Alej9494/rpn-calculator/hardware/kicad/rpn-calculator.kicad_sch

## KiCad design hardware/kicad/rpn-calculator.kicad_sch (2026-11-07)

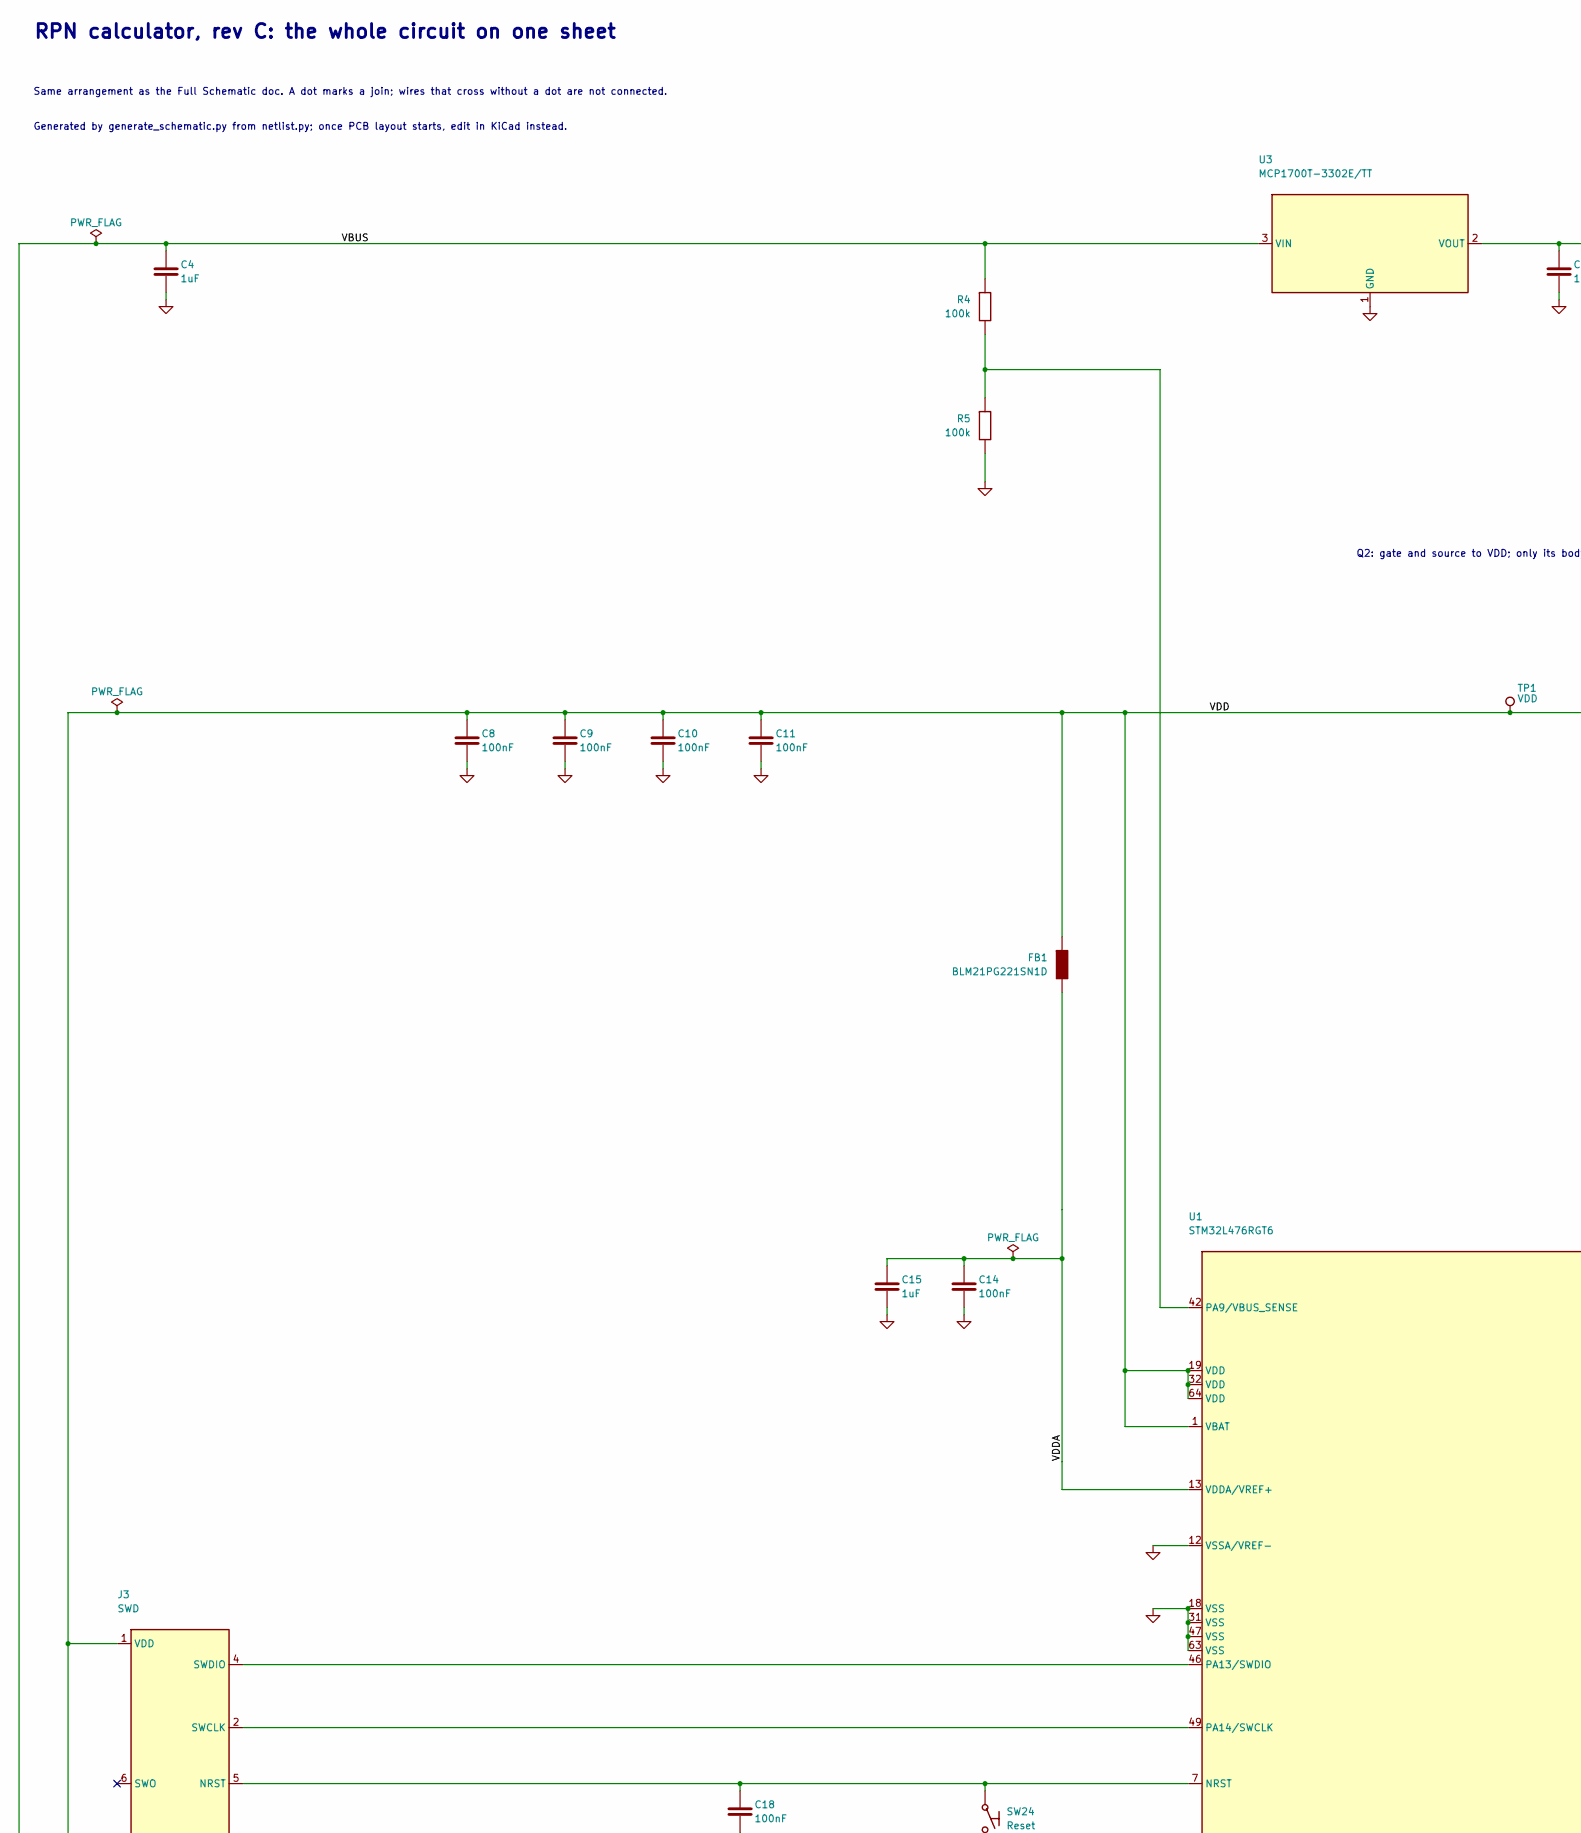
[picture p3: schematic rpn-calculator.kicad_sch, part in row 1, column 1]

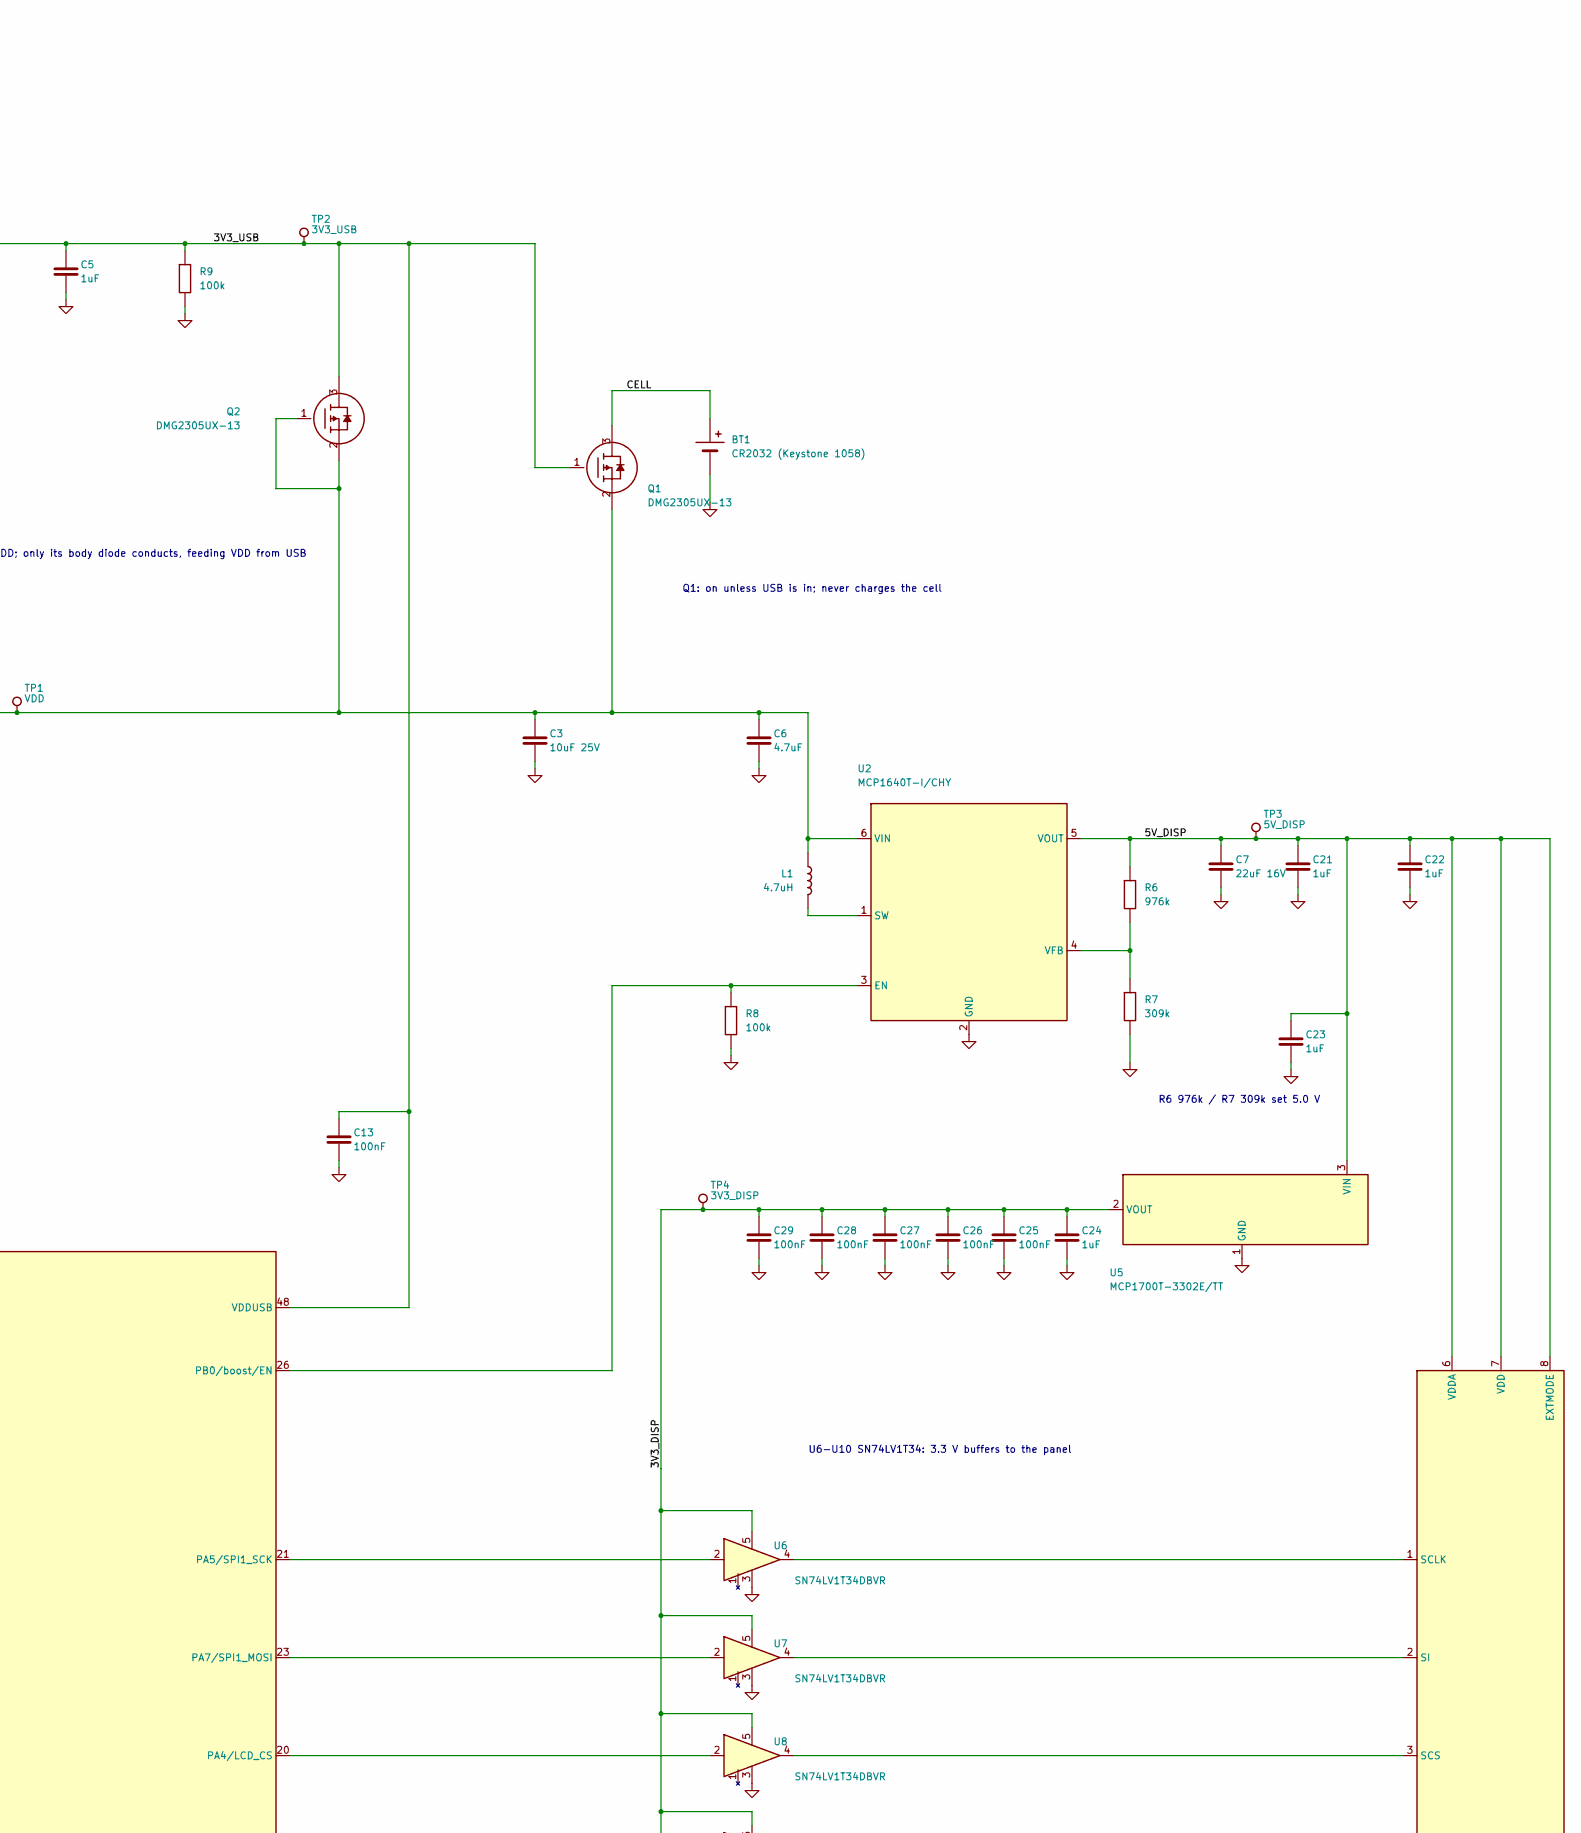
[picture p4: schematic rpn-calculator.kicad_sch, part in row 1, column 2]

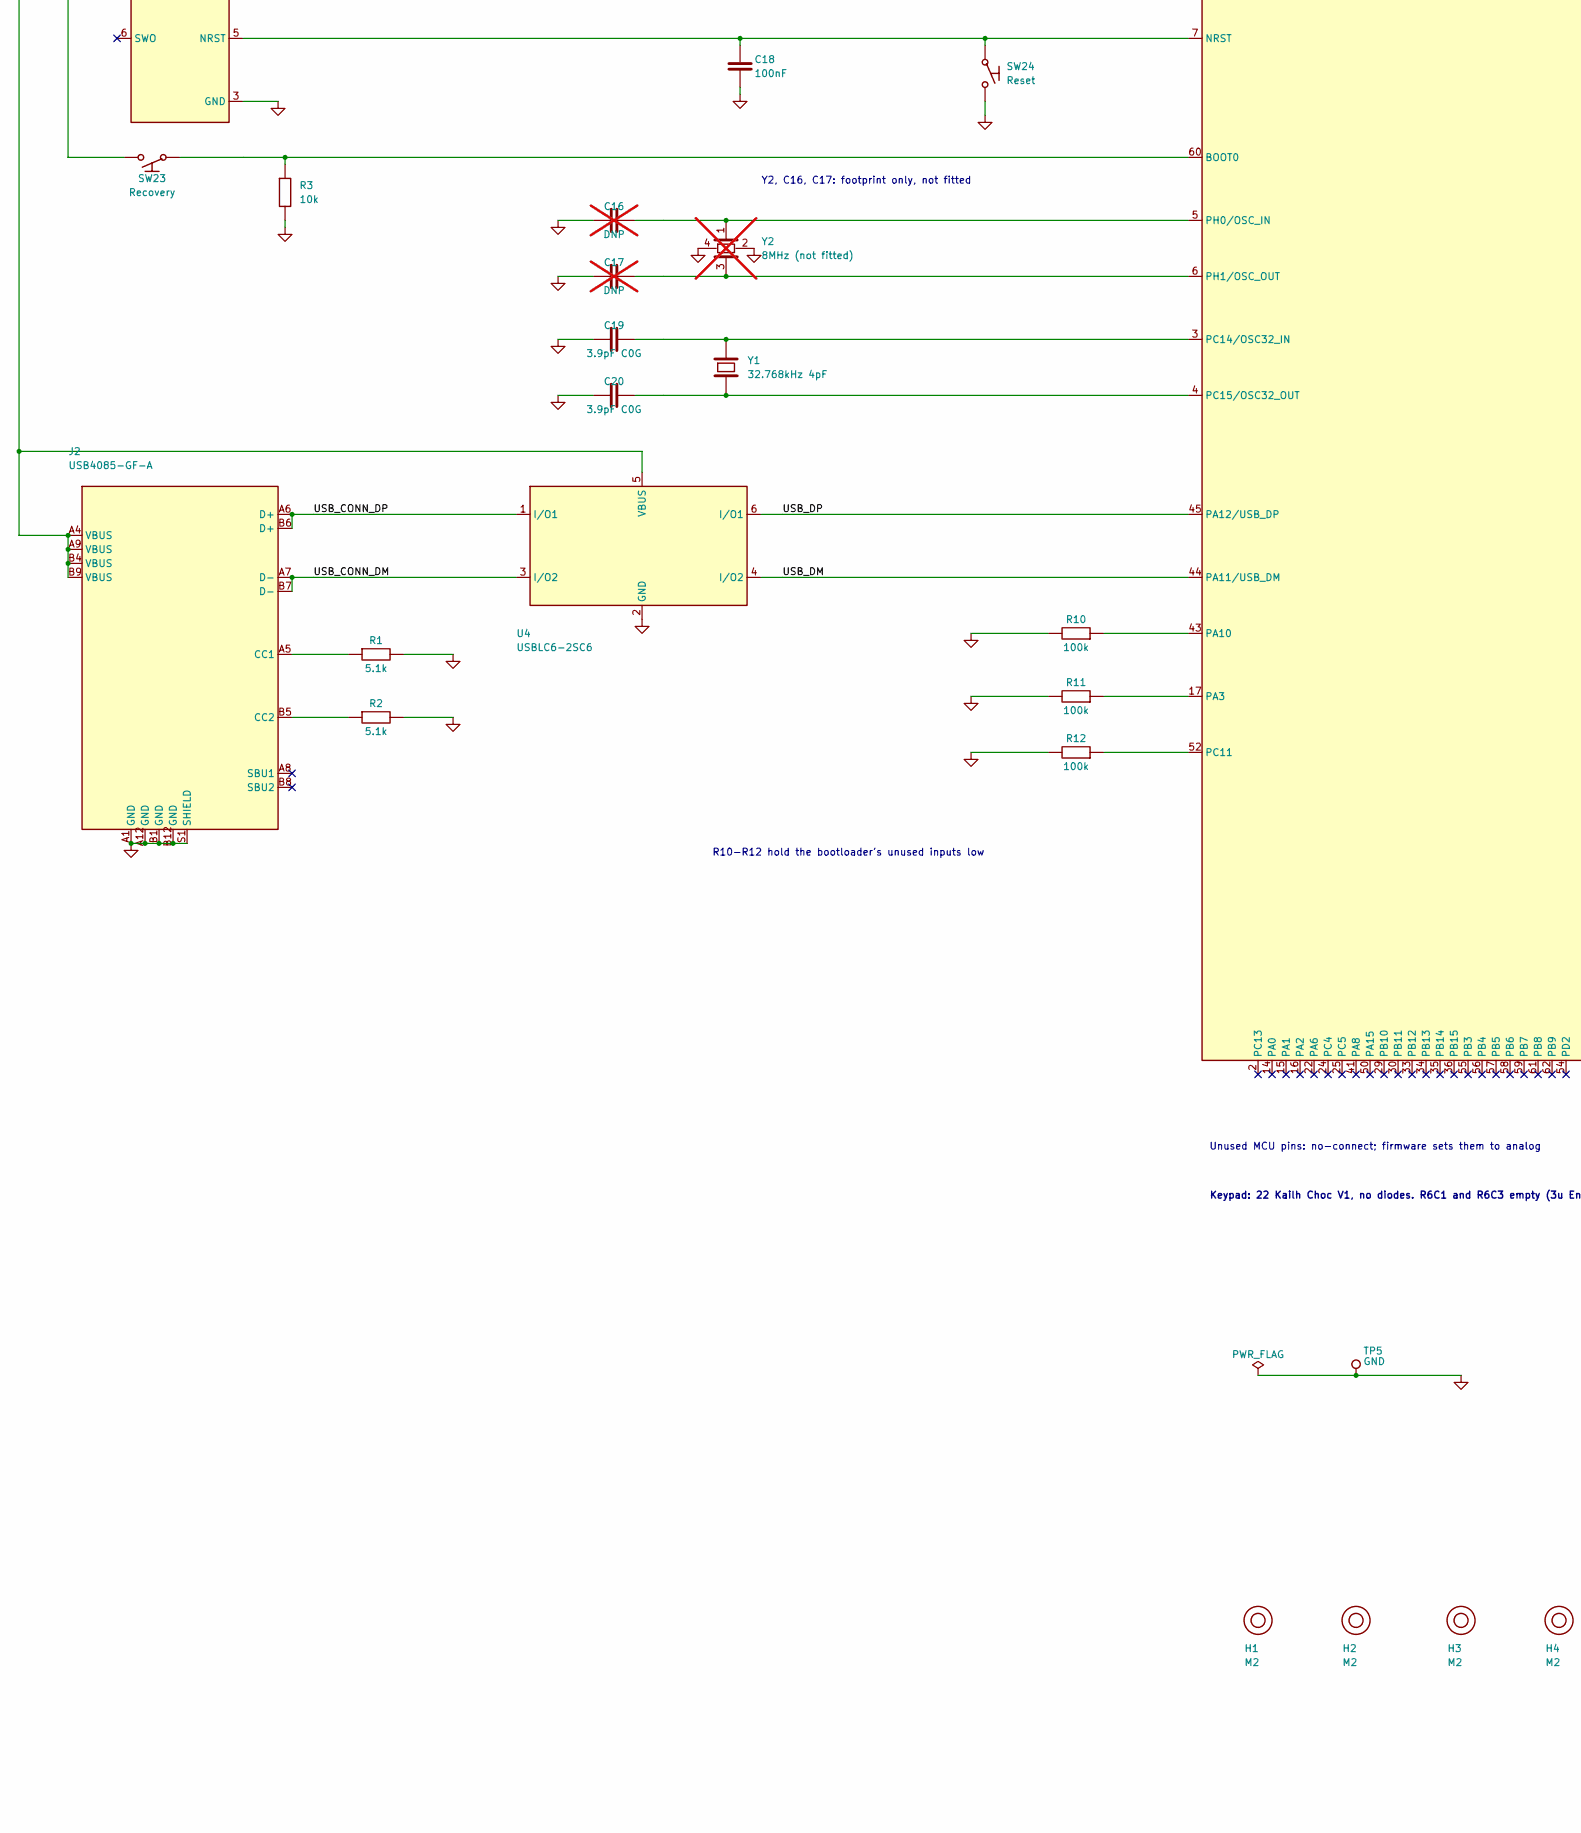
[picture p5: schematic rpn-calculator.kicad_sch, part in row 2, column 1]

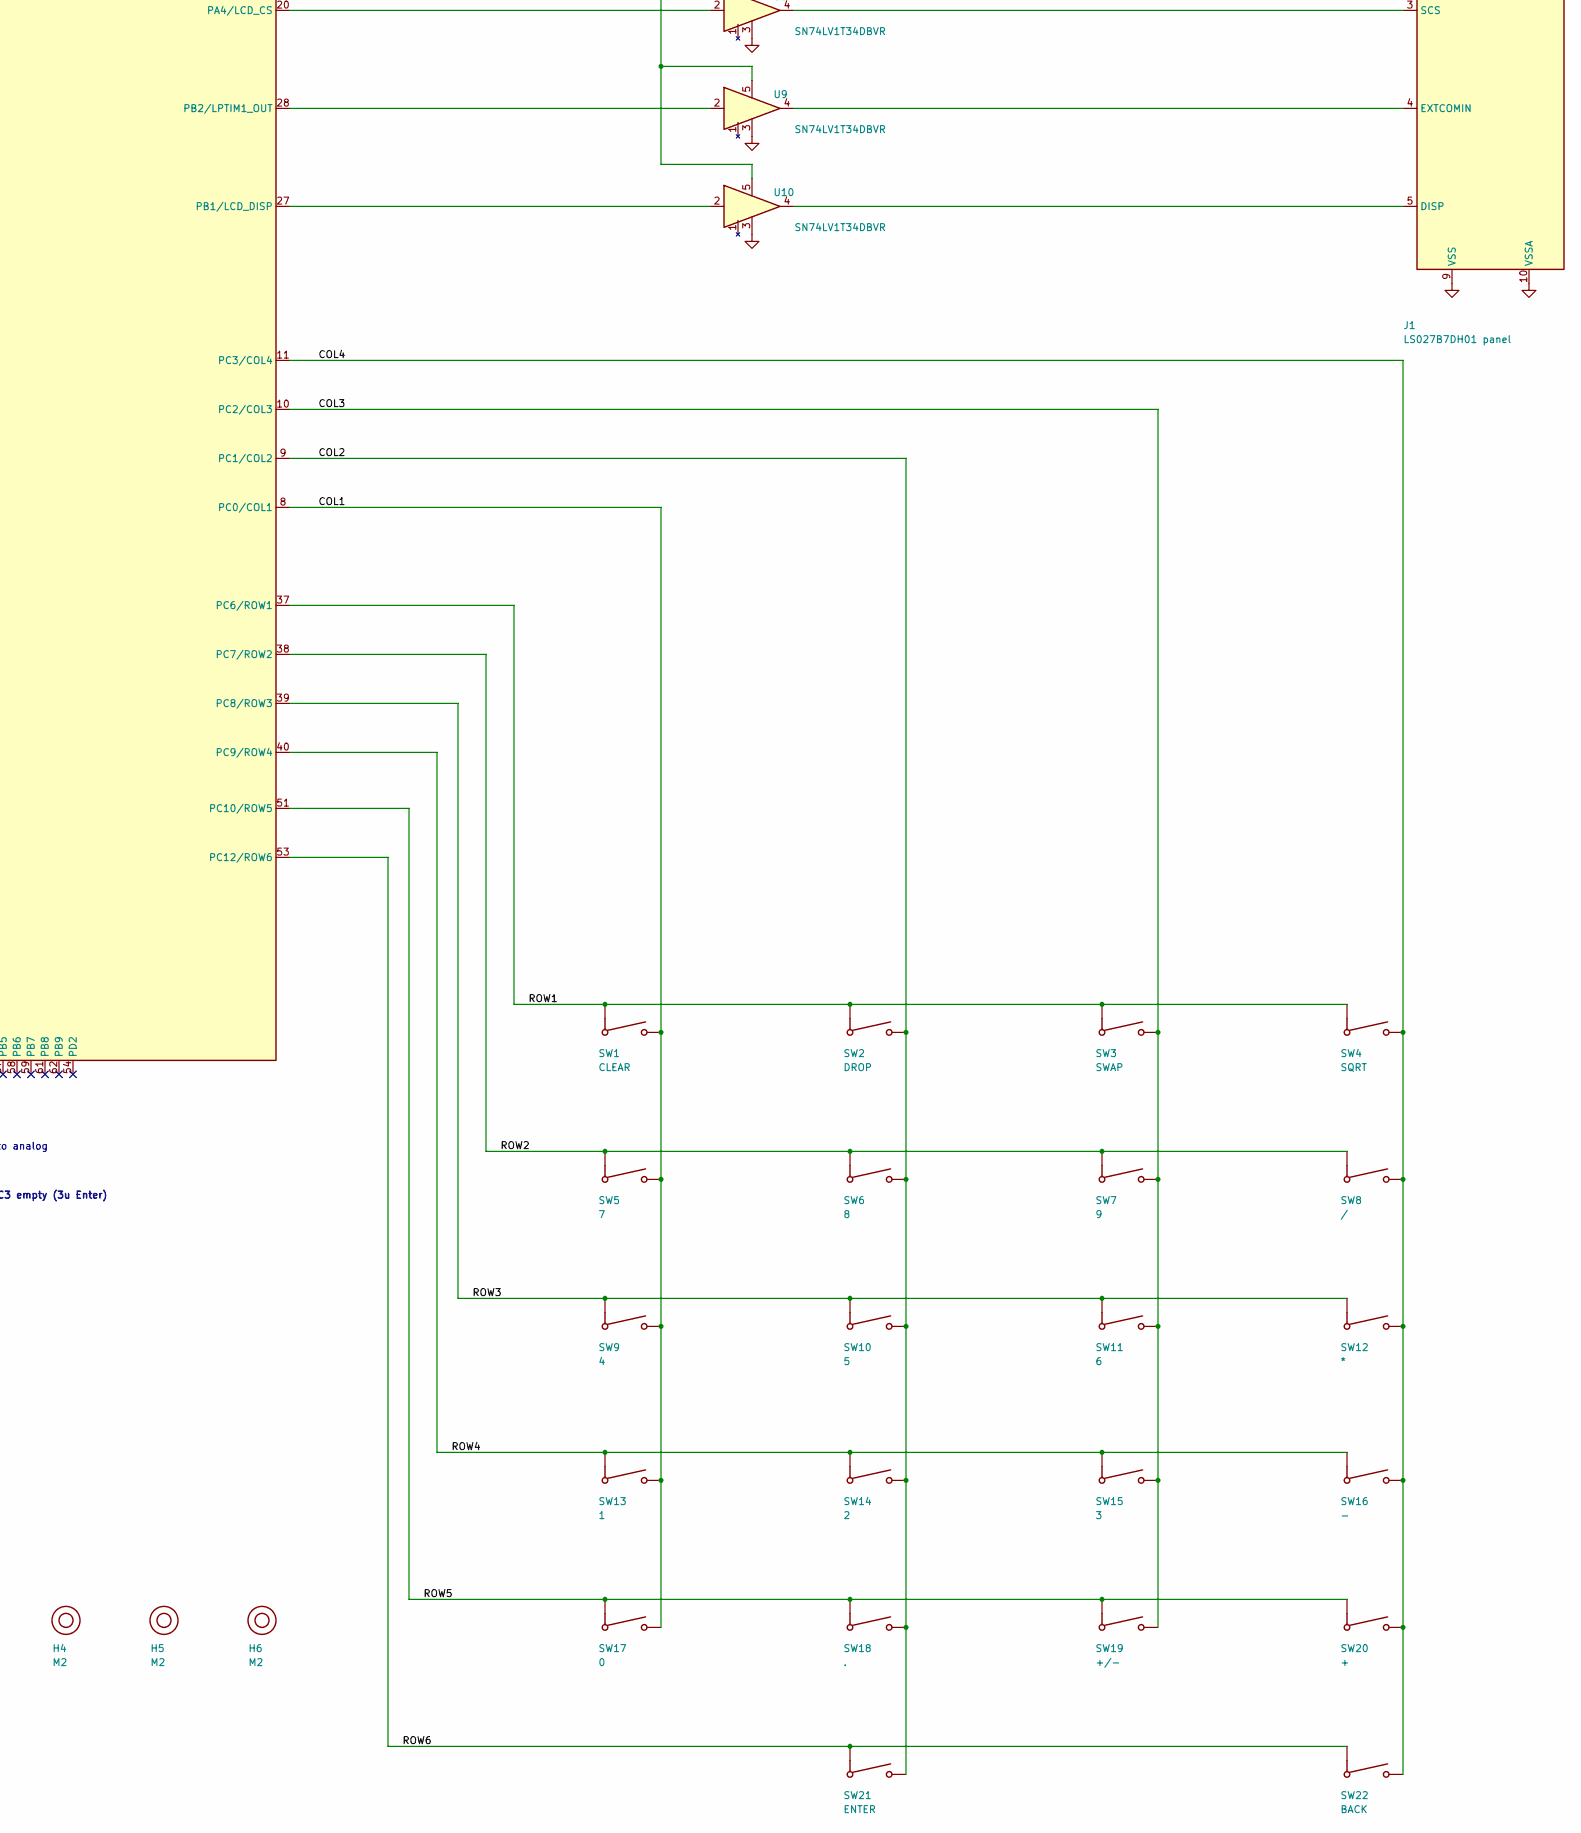
[picture p6: schematic rpn-calculator.kicad_sch, part in row 2, column 2]

Parts:
BT1: CR2032 (Keystone 1058); BatteryHolder_Keystone_1058_1x2032; MPN Keystone 1058
C3: 10uF 25V; C_1206_3216Metric; MPN C3216X5R1E106K160AB
C4, C5, C15, C21, C22, C23, C24: 1uF; C_0805_2012Metric; MPN CL21B105KAFNNNE
C6: 4.7uF; C_0805_2012Metric; MPN CL21A475KAQNNNE
C7: 22uF 16V; C_0805_2012Metric; MPN CL21A226MOQNNNE
C8, C9, C10, C11, C13, C14, C18, C25, C26, C27, C28, C29: 100nF; C_0805_2012Metric; MPN CL21B104KBCNNNC
C16, C17: DNP; C_0805_2012Metric; not fitted
C19, C20: 3.9pF C0G; C_0805_2012Metric
FB1: BLM21PG221SN1D; L_0805_2012Metric; MPN BLM21PG221SN1D
H1, H2, H3, H4, H5, H6: M2; MountingHole_2.2mm_M2
J1: LS027B7DH01 panel; Wurth_687110183622_1x10-1MP_P0.50mm_Horizontal; MPN Wurth 687110183622
J2: USB4085-GF-A; USB_C_Receptacle_GCT_USB4085; MPN GCT USB4085-GF-A
J3: SWD; PinHeader_1x06_P2.54mm_Vertical
L1: 4.7uH; L_Wuerth_WE-LQS-4018; MPN Wurth 74404042047
Q1, Q2: DMG2305UX-13; SOT-23; MPN DMG2305UX-13
R1, R2: 5.1k; R_0805_2012Metric
R3: 10k; R_0805_2012Metric; MPN RC0805FR-0710KL
R4, R5, R8, R9, R10, R11, R12: 100k; R_0805_2012Metric; MPN RC0805FR-07100KL
R6: 976k; R_0805_2012Metric; MPN RC0805FR-07976KL
R7: 309k; R_0805_2012Metric; MPN RC0805FR-07309KL
SW1: CLEAR; SW_Kailh_Choc_V1_1.00u; MPN Kailh Choc V1
SW2: DROP; SW_Kailh_Choc_V1_1.00u; MPN Kailh Choc V1
SW3: SWAP; SW_Kailh_Choc_V1_1.00u; MPN Kailh Choc V1
SW4: SQRT; SW_Kailh_Choc_V1_1.00u; MPN Kailh Choc V1
SW5: 7; SW_Kailh_Choc_V1_1.00u; MPN Kailh Choc V1
SW6: 8; SW_Kailh_Choc_V1_1.00u; MPN Kailh Choc V1
SW7: 9; SW_Kailh_Choc_V1_1.00u; MPN Kailh Choc V1
SW8: /; SW_Kailh_Choc_V1_1.00u; MPN Kailh Choc V1
SW9: 4; SW_Kailh_Choc_V1_1.00u; MPN Kailh Choc V1
SW10: 5; SW_Kailh_Choc_V1_1.00u; MPN Kailh Choc V1
SW11: 6; SW_Kailh_Choc_V1_1.00u; MPN Kailh Choc V1
SW12: *; SW_Kailh_Choc_V1_1.00u; MPN Kailh Choc V1
SW13: 1; SW_Kailh_Choc_V1_1.00u; MPN Kailh Choc V1
SW14: 2; SW_Kailh_Choc_V1_1.00u; MPN Kailh Choc V1
SW15: 3; SW_Kailh_Choc_V1_1.00u; MPN Kailh Choc V1
SW16: -; SW_Kailh_Choc_V1_1.00u; MPN Kailh Choc V1
SW17: 0; SW_Kailh_Choc_V1_1.00u; MPN Kailh Choc V1
SW18: .; SW_Kailh_Choc_V1_1.00u; MPN Kailh Choc V1
SW19: +/-; SW_Kailh_Choc_V1_1.00u; MPN Kailh Choc V1
SW20: +; SW_Kailh_Choc_V1_1.00u; MPN Kailh Choc V1
SW21: ENTER; SW_Kailh_Choc_V1_1.00u; MPN Kailh Choc V1
SW22: BACK; SW_Kailh_Choc_V1_1.00u; MPN Kailh Choc V1
SW23: Recovery; SW_SPST_B3U-1000P; MPN B3U-1000P
SW24: Reset; SW_SPST_B3U-1000P; MPN B3U-1000P
TP1: VDD; TestPoint_Pad_D1.5mm
TP2: 3V3_USB; TestPoint_Pad_D1.5mm
TP3: 5V_DISP; TestPoint_Pad_D1.5mm
TP4: 3V3_DISP; TestPoint_Pad_D1.5mm
TP5: GND; TestPoint_Pad_D1.5mm
U1: STM32L476RGT6; LQFP-64_10x10mm_P0.5mm; MPN STM32L476RGT6
U2: MCP1640T-I/CHY; SOT-23-6; MPN MCP1640T-I/CHY
U3, U5: MCP1700T-3302E/TT; SOT-23; MPN MCP1700T-3302E/TT
U4: USBLC6-2SC6; SOT-23-6; MPN USBLC6-2SC6
U6, U7, U8, U9, U10: SN74LV1T34DBVR; SOT-23-5; MPN SN74LV1T34DBVR
Y1: 32.768kHz 4pF; Crystal_SMD_2012-2Pin_2.0x1.2mm; MPN CM8V-T1A-32.768KHZ-4PF-20PPM-TA-QC
Y2: 8MHz (not fitted); Crystal_SMD_3225-4Pin_3.2x2.5mm_HandSoldering; not fitted

Connections:
3V3_DISP: C24.1, C25.1, C26.1, C27.1, C28.1, C29.1, TP4.1, U5.2 (VOUT), U6.5 (VCC), U7.5 (VCC), U8.5 (VCC), U9.5 (VCC), U10.5 (VCC)
3V3_USB: C5.1, C13.1, Q1.1 (G), Q2.3 (D), R9.1, TP2.1, U1.48 (VDDUSB), U3.2 (VOUT)
5V_DISP: C7.1, C21.1, C22.1, C23.1, J1.6 (VDDA), J1.7 (VDD), J1.8 (EXTMODE), R6.1, TP3.1, U2.5 (VOUT), U5.3 (VIN)
CELL: BT1.1, Q1.3 (D)
COL1: SW1.2, SW5.2, SW9.2, SW13.2, SW17.2, U1.8 (PC0/COL1)
COL2: SW2.2, SW6.2, SW10.2, SW14.2, SW18.2, SW21.2, U1.9 (PC1/COL2)
COL3: SW3.2, SW7.2, SW11.2, SW15.2, SW19.2, U1.10 (PC2/COL3)
COL4: SW4.2, SW8.2, SW12.2, SW16.2, SW20.2, SW22.2, U1.11 (PC3/COL4)
GND: BT1.2, C3.2, C4.2, C5.2, C6.2, C7.2, C8.2, C9.2, C10.2, C11.2, C13.2, C14.2, C15.2, C16.2, C17.2, C18.2, C19.2, C20.2, C21.2, C22.2, C23.2, C24.2, C25.2, C26.2, C27.2, C28.2, C29.2, J1.9 (VSS), J1.10 (VSSA), J2.A1 (GND), J2.A12 (GND), J2.B1 (GND), J2.B12 (GND), J2.S1 (SHIELD), J3.3 (GND), R1.2, R2.2, R3.2, R5.2, R7.2, R8.2, R9.2, R10.2, R11.2, R12.2, SW24.2, TP5.1, U1.12 (VSSA/VREF-), U1.18 (VSS), U1.31 (VSS), U1.47 (VSS), U1.63 (VSS), U2.2 (GND), U3.1 (GND), U4.2 (GND), U5.1 (GND), U6.3 (GND), U7.3 (GND), U8.3 (GND), U9.3 (GND), U10.3 (GND), Y2.2, Y2.4
unnamed: C16.1, U1.5 (PH0/OSC_IN), Y2.1
unnamed: C17.1, U1.6 (PH1/OSC_OUT), Y2.3
unnamed: C18.1, J3.5 (NRST), SW24.1, U1.7 (NRST)
unnamed: C19.1, U1.3 (PC14/OSC32_IN), Y1.1
unnamed: C20.1, U1.4 (PC15/OSC32_OUT), Y1.2
unnamed: J1.1 (SCLK), U6.4 (Y)
unnamed: J1.2 (SI), U7.4 (Y)
unnamed: J1.3 (SCS), U8.4 (Y)
unnamed: J1.4 (EXTCOMIN), U9.4 (Y)
unnamed: J1.5 (DISP), U10.4 (Y)
unnamed: J2.A5 (CC1), R1.1
unnamed: J2.B5 (CC2), R2.1
unnamed: J3.2 (SWCLK), U1.49 (PA14/SWCLK)
unnamed: J3.4 (SWDIO), U1.46 (PA13/SWDIO)
unnamed: L1.2, U2.1 (SW)
unnamed: R3.1, SW23.1, U1.60 (BOOT0)
unnamed: R4.2, R5.1, U1.42 (PA9/VBUS_SENSE)
unnamed: R6.2, R7.1, U2.4 (VFB)
unnamed: R8.1, U1.26 (PB0/boost/EN), U2.3 (EN)
unnamed: R10.1, U1.43 (PA10)
unnamed: R11.1, U1.17 (PA3)
unnamed: R12.1, U1.52 (PC11)
unnamed: U1.20 (PA4/LCD_CS), U8.2 (A)
unnamed: U1.21 (PA5/SPI1_SCK), U6.2 (A)
unnamed: U1.23 (PA7/SPI1_MOSI), U7.2 (A)
unnamed: U1.27 (PB1/LCD_DISP), U10.2 (A)
unnamed: U1.28 (PB2/LPTIM1_OUT), U9.2 (A)
ROW1: SW1.1, SW2.1, SW3.1, SW4.1, U1.37 (PC6/ROW1)
ROW2: SW5.1, SW6.1, SW7.1, SW8.1, U1.38 (PC7/ROW2)
ROW3: SW9.1, SW10.1, SW11.1, SW12.1, U1.39 (PC8/ROW3)
ROW4: SW13.1, SW14.1, SW15.1, SW16.1, U1.40 (PC9/ROW4)
ROW5: SW17.1, SW18.1, SW19.1, SW20.1, U1.51 (PC10/ROW5)
ROW6: SW21.1, SW22.1, U1.53 (PC12/ROW6)
USB_CONN_DM: J2.A7 (D-), J2.B7 (D-), U4.3 (I/O2)
USB_CONN_DP: J2.A6 (D+), J2.B6 (D+), U4.1 (I/O1)
USB_DM: U1.44 (PA11/USB_DM), U4.4 (I/O2)
USB_DP: U1.45 (PA12/USB_DP), U4.6 (I/O1)
VBUS: C4.1, J2.A4 (VBUS), J2.A9 (VBUS), J2.B4 (VBUS), J2.B9 (VBUS), R4.1, U3.3 (VIN), U4.5 (VBUS)
VDD: C3.1, C6.1, C8.1, C9.1, C10.1, C11.1, FB1.1, J3.1 (VDD), L1.1, Q1.2 (S), Q2.1 (G), Q2.2 (S), SW23.2, TP1.1, U1.1 (VBAT), U1.19 (VDD), U1.32 (VDD), U1.64 (VDD), U2.6 (VIN)
VDDA: C14.1, C15.1, FB1.2, U1.13 (VDDA/VREF+)

Notes on the sheet:
RPN calculator, rev C: the whole circuit on one sheet
Same arrangement as the Full Schematic doc. A dot marks a join; wires that cross without a dot are not connected.
Generated by generate_schematic.py from netlist.py; once PCB layout starts, edit in KiCad instead.
Q2: gate and source to VDD; only its body diode conducts, feeding VDD from USB
Q1: on unless USB is in; never charges the cell
R6 976k / R7 309k set 5.0 V
U6-U10 SN74LV1T34: 3.3 V buffers to the panel
R10-R12 hold the bootloader's unused inputs low
Y2, C16, C17: footprint only, not fitted
Keypad: 22 Kailh Choc V1, no diodes. R6C1 and R6C3 empty (3u Enter)
Unused MCU pins: no-connect; firmware sets them to analog
