Alej9494/rpn-calculator/(commit log)

2026-11-04 Firmware stage 1: full spec behaviour with floating-point maths
    HP 48-style entry, unlimited stack, errors, CLEAR hold-to-off and
    simulated 5-minute auto-off, on the Nucleo with D-pin wiring.
    Claude-Session: https://claude.ai/code/session_017rNYU3fbSiztmBqVNXSzh1
    [rpn_calculator.ino]
2026-11-04 Firmware stage 2: exact 12-digit BCD maths
    Stage 1 behaviour with BCD arithmetic in place of floating point,
    plus the computer-side BCD test suite (about 265,000 vectors).
    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
2026-11-04 Firmware stage 3: DejaVu Sans Condensed Bold fonts
    Equal-width digits and a true minus sign throughout.
    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
2026-11-04 Firmware stage 4: real Stop 2 sleep
    Stack kept in RAM between key presses; keypad moved to the PCB's
    port C pins, each column on its own wake-up line.
    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
2026-11-04 Firmware stage 5: battery indicator
    Supply voltage measured against VREFINT, shown as a status-line icon.
    Keypad ROW6 moved from PC11 to PC12, because the ST bootloader listens
    on PC11 as USART3 RX.
    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
2026-11-04 Add screen layout and battery icon images to the design doc
    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
2026-11-04 Add CLAUDE.md, hardware BOMs and refresh design open items
    CLAUDE.md links the live spec and Full Schematic docs and records the
    key hardware decisions so each session starts with the project context.
    BOM text and Digi-Key CSV go in hardware/. DESIGN.md open items now point
    to the spec's checklist; BAT54C and AO3400 marked as not used.
    Claude-Session: https://claude.ai/code/session_017rNYU2RgkhgCA6WaNA8d24
    [BOM-DigiKey.csv]
2026-11-04 Order Q1/Q2 as DMG2305UX-13
    DMG2305UX-7 is out of stock at Digi-Key. The -13 is the same part on a
    larger reel, so the design and footprint are unchanged.
    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
    [BOM-DigiKey.csv]
2026-11-04 Replace out-of-stock L1, R1/R2, C3 and C7
    L1: Wurth 74404042047 (WE-LQS 4018) replaces Coilcraft LPS4018-472MRB.
    R1/R2: Panasonic ERJ-6ENF5101V replaces Yageo RC0805FR-075K1L.
    C3: Samsung CL21A106KOQNNNE (16 V) replaces CL21A106KAYNNNE.
    C7: Samsung CL21A226MOQNNNE (16 V) replaces CL21A226MAQNNNE.
    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
    [BOM-DigiKey.csv]
2026-11-04 C3 becomes a 1206 TDK part; R1/R2 from own stock
    C3: TDK C3216X5R1E106K160AB, 10 uF 25 V X5R, 1206 size (0805 parts
    out of stock). R1/R2 come from Alex's stock, so they are off the
    Digi-Key order. C7 Samsung CL21A226MOQNNNE confirmed in stock.
    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
    [BOM-DigiKey.csv]
2026-11-06 Add list of future software enhancements
    Ideas for improving the firmware and web app without hardware changes:
    undo, too-few-arguments behaviour, stack browser, FIX 2, small fixes,
    battery-life and robustness items, and a shared logic module.
    Claude-Session: https://claude.ai/code/session_017rNYU2Fz6wQ8yQttkU1c2y
2026-11-06 Firmware stage 6: undo on BACK and "too few arguments" error
    - BACK with nothing typed restores the stack from before the last key
    that changed it (one level, HP 48 style); BACK again redoes. CLEAR
    can be undone.
    - Operations with missing operands now show "Error: too few arguments"
    instead of treating them as 0 (+ - * / SWAP need 2; SQRT DROP +/-
    ENTER-duplicate need 1).
    - Add shared keystroke tests in tests/keystrokes.txt; update DESIGN.md,
    CLAUDE.md and SOFTWARE-IDEAS.md.
    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
    [rpn_calculator.ino]
2026-11-06 Web app: undo on BACK and "too few arguments" error
    Brings the web app in line with firmware stage 6. All 28 shared
    keystroke tests in tests/keystrokes.txt pass in Chromium. Also gives
    the page a proper <head> so the file stands on its own.
    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
2026-11-07 KiCad project: rev C schematic on one sheet
    Generated from the spec's rev C netlist by hardware/kicad/generate_schematic.py;
    check_schematic.py rebuilds the netlist from the drawing to confirm it.
    Claude-Session: https://claude.ai/code/session_017rNYU5yex5fgMiuvxenMZu
    [rpn-calculator.kicad_sch]
2026-11-07 KiCad schematic: draw every connection as a wire
    Same arrangement as the Full Schematic doc on one A1 sheet, with junction
    dots and ground symbols. Parts and connections move to netlist.py; both the
    generator and check_schematic.py confirm the drawing matches it. The USB
    lines are drawn flow-through U4, so the connector side becomes
    USB_CONN_DP/DM.
    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
    [rpn-calculator.kicad_sch]
2026-11-07 KiCad: footprints for the keys, J1 and Y2
    Choc V1 footprint from the kiswitch library, J1 drawn from the Wurth land
    pattern, Y2 as a 3225 four-pad crystal with its case grounded. L1 still
    needs Wurth's land pattern.
    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
    [rpn-calculator.kicad_sch]
2026-11-07 KiCad: restore the Choc footprint file intact
    Removing only the first line of its multi-line 3D model entry had left an
    unmatched bracket, so KiCad could not load it.
    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
2026-11-07 L1 footprint and Wurth 74404042047 datasheet
    L_Wuerth_WE-LQS-4018 drawn from the datasheet's recommended land pattern
    (two 1.5 x 3.6 mm pads, 1.55 mm apart). Datasheet added to docs/datasheets
    and its README table.
    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
    [rpn-calculator.kicad_sch]
